SepehrMosavat/SOCRAETES/hardware/recorder/Recorder_BOM.txt

The Bill of Materials for the SOCRAETES Recorder can be found here:
https://octopart.com/bom-tool/nM2bvLOp
