SepehrMosavat/SOCRAETES/hardware/emulator/Emulator_BOM.txt

The Bill of Materials for the SOCRAETES Emulator can be found here:
https://octopart.com/bom-tool/IVWPdzGF
