SepehrMosavat/SOCRAETES/software/recorder/recording_data/measurement0.csv

20.04.2023 | 13:47:32:000 | 13:49:12:0000 | Indoor | 50 | sunny | N/A | N/A
40 | 727425 | 340
0 | 2891975 | 79
1 | 2894190 | 58
2 | 2877372 | 70
3 | 2852698 | 78
4 | 2814932 | 92
5 | 2760448 | 111
6 | 2676154 | 141
7 | 2537175 | 181
8 | 2285401 | 244
9 | 1624747 | 327
10 | 51966 | 376
11 | 25580 | 388
12 | 14703 | 395
13 | 8258 | 372
14 | 4330 | 385
15 | 2114 | 385
16 | 1007 | 401
17 | 503 | 391
18 | 503 | 386
19 | 201 | 388
20 | 201 | 391
21 | 201 | 392
22 | 302 | 381
23 | 201 | 377
24 | 302 | 392
25 | 201 | 399
26 | 201 | 364
27 | 201 | 399
28 | 201 | 392
29 | 201 | 386
30 | 201 | 402
31 | 201 | 391
32 | 201 | 390
33 | 201 | 374
34 | 302 | 378
35 | 201 | 395
36 | 302 | 392
37 | 201 | 387
38 | 201 | 407
39 | 201 | 410
0 | 2890363 | 61
1 | 2892277 | 61
2 | 2875257 | 65
3 | 2851691 | 78
4 | 2813824 | 83
5 | 2759642 | 107
6 | 2675651 | 124
7 | 2536470 | 178
8 | 2285099 | 249
9 | 1626660 | 324
10 | 51059 | 392
11 | 24270 | 398
12 | 14200 | 392
13 | 7452 | 404
14 | 4129 | 391
15 | 2215 | 386
16 | 704 | 394
17 | 503 | 401
18 | 302 | 374
19 | 201 | 375
20 | 201 | 389
21 | 302 | 394
22 | 302 | 392
23 | 302 | 379
24 | 201 | 393
25 | 201 | 379
26 | 201 | 383
27 | 201 | 380
28 | 201 | 383
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
