SepehrMosavat/SOCRAETES/software/recorder/recording_data/measurement1.csv

20.04.2023 | 13:49:14:000 | 13:50:54:0000 | Indoor | 50 | sunny | N/A | N/A
0 | 2871833 | 44
1 | 2873142 | 61
2 | 2856525 | 66
3 | 2831247 | 78
4 | 2792574 | 78
5 | 2736580 | 97
6 | 2649567 | 125
7 | 2505552 | 164
8 | 2236859 | 228
9 | 1498356 | 320
10 | 46427 | 381
11 | 22659 | 359
12 | 12387 | 374
13 | 6747 | 360
14 | 3121 | 380
15 | 1409 | 373
16 | 503 | 369
17 | 201 | 378
18 | 201 | 358
19 | 201 | 372
20 | 201 | 393
21 | 201 | 369
22 | 201 | 380
23 | 201 | 373
24 | 201 | 380
25 | 201 | 367
26 | 201 | 390
27 | 201 | 385
28 | 201 | 385
29 | 201 | 384
30 | 201 | 386
31 | 201 | 376
32 | 201 | 387
33 | 201 | 385
34 | 201 | 370
35 | 302 | 374
36 | 201 | 386
37 | 201 | 381
38 | 302 | 383
39 | 201 | 376
0 | 2871430 | 47
1 | 2873142 | 61
2 | 2857129 | 58
3 | 2831348 | 78
4 | 2791668 | 89
5 | 2736177 | 118
6 | 2649365 | 121
7 | 2504344 | 180
8 | 2236456 | 238
9 | 1496342 | 330
10 | 47534 | 375
11 | 22961 | 385
12 | 12185 | 389
13 | 6848 | 379
14 | 3121 | 381
15 | 1409 | 375
16 | 604 | 391
17 | 302 | 389
18 | 302 | 360
19 | 201 | 371
20 | 201 | 356
21 | 201 | 372
22 | 201 | 365
23 | 201 | 387
24 | 201 | 370
25 | 201 | 387
26 | 201 | 367
27 | 201 | 376
28 | 201 | 375
29 | 201 | 379
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
