SepehrMosavat/SOCRAETES/software/recorder/recording_data/measurement2.csv

20.04.2023 | 13:50:56:000 | 13:52:36:0000 | Indoor | 50 | sunny | N/A | N/A
0 | 2932561 | 41
1 | 2933870 | 63
2 | 2918260 | 71
3 | 2894996 | 73
4 | 2859043 | 91
5 | 2806271 | 98
6 | 2727113 | 142
7 | 2595788 | 171
8 | 2365969 | 250
9 | 1803305 | 341
10 | 58210 | 417
11 | 26688 | 403
12 | 15307 | 398
13 | 7754 | 405
14 | 4330 | 397
15 | 1913 | 406
16 | 906 | 407
17 | 503 | 405
18 | 503 | 407
19 | 201 | 416
20 | 302 | 418
21 | 201 | 388
22 | 201 | 381
23 | 201 | 397
24 | 201 | 396
25 | 201 | 420
26 | 201 | 412
27 | 201 | 420
28 | 201 | 418
29 | 201 | 405
30 | 302 | 404
31 | 201 | 409
32 | 201 | 417
33 | 302 | 404
34 | 302 | 400
35 | 302 | 403
36 | 201 | 394
37 | 201 | 408
38 | 302 | 411
39 | 201 | 414
0 | 2931050 | 63
1 | 2934373 | 71
2 | 2918059 | 68
3 | 2894392 | 60
4 | 2859848 | 89
5 | 2806170 | 102
6 | 2726811 | 107
7 | 2596090 | 185
8 | 2365566 | 217
9 | 1804715 | 324
10 | 58008 | 416
11 | 26083 | 394
12 | 14401 | 403
13 | 8157 | 424
14 | 4229 | 407
15 | 1510 | 401
16 | 1007 | 414
17 | 604 | 401
18 | 302 | 400
19 | 201 | 425
20 | 201 | 417
21 | 201 | 395
22 | 201 | 402
23 | 201 | 400
24 | 201 | 414
25 | 201 | 407
26 | 201 | 419
27 | 201 | 404
28 | 201 | 399
29 | 201 | 394
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
