SepehrMosavat/SOCRAETES/software/recorder/recording_data/measurement3.csv

20.04.2023 | 13:52:38:000 | 13:54:18:0000 | Indoor | 50 | sunny | N/A | N/A
0 | 2925310 | 40
1 | 2927424 | 64
2 | 2911815 | 69
3 | 2887544 | 74
4 | 2851590 | 98
5 | 2797610 | 102
6 | 2716740 | 147
7 | 2582796 | 169
8 | 2344014 | 239
9 | 1747914 | 339
10 | 55390 | 406
11 | 26083 | 416
12 | 14401 | 394
13 | 7754 | 408
14 | 3927 | 397
15 | 1913 | 394
16 | 805 | 403
17 | 402 | 412
18 | 201 | 419
19 | 402 | 410
20 | 201 | 408
21 | 201 | 384
22 | 201 | 406
23 | 201 | 407
24 | 201 | 394
25 | 201 | 411
26 | 201 | 407
27 | 201 | 423
28 | 201 | 406
29 | 201 | 408
30 | 201 | 408
31 | 302 | 401
32 | 201 | 400
33 | 201 | 415
34 | 201 | 399
35 | 302 | 394
36 | 201 | 407
37 | 201 | 405
38 | 201 | 414
39 | 201 | 415
0 | 2925310 | 67
1 | 2927727 | 61
2 | 2911613 | 58
3 | 2886134 | 76
4 | 2851590 | 83
5 | 2797106 | 128
6 | 2716539 | 126
7 | 2582091 | 174
8 | 2343813 | 244
9 | 1750432 | 322
10 | 55893 | 395
11 | 26486 | 410
12 | 13998 | 422
13 | 7855 | 392
14 | 3625 | 408
15 | 1812 | 399
16 | 1007 | 413
17 | 402 | 405
18 | 302 | 395
19 | 302 | 407
20 | 201 | 401
21 | 201 | 410
22 | 302 | 398
23 | 201 | 422
24 | 201 | 406
25 | 201 | 390
26 | 201 | 388
27 | 201 | 401
28 | 201 | 426
29 | 201 | 398
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
