SepehrMosavat/SOCRAETES/software/recorder/recording_data/measurement4.csv

20.04.2023 | 13:54:20:000 | 13:56:00:0000 | Indoor | 50 | sunny | N/A | N/A
0 | 2889256 | 42
1 | 2890968 | 61
2 | 2873948 | 75
3 | 2848468 | 63
4 | 2809997 | 90
5 | 2753701 | 123
6 | 2665983 | 122
7 | 2520054 | 187
8 | 2251160 | 247
9 | 1512959 | 333
10 | 47434 | 390
11 | 23364 | 384
12 | 13293 | 403
13 | 7553 | 396
14 | 3121 | 398
15 | 1409 | 400
16 | 604 | 390
17 | 503 | 387
18 | 302 | 379
19 | 201 | 402
20 | 201 | 392
21 | 201 | 384
22 | 201 | 398
23 | 201 | 383
24 | 201 | 387
25 | 201 | 413
26 | 201 | 390
27 | 201 | 387
28 | 302 | 377
29 | 201 | 383
30 | 302 | 399
31 | 201 | 398
32 | 201 | 390
33 | 201 | 407
34 | 201 | 409
35 | 302 | 387
36 | 201 | 409
37 | 302 | 392
38 | 201 | 392
39 | 201 | 384
0 | 2888651 | 60
1 | 2890363 | 62
2 | 2872941 | 85
3 | 2848871 | 74
4 | 2809292 | 114
5 | 2752693 | 114
6 | 2665580 | 129
7 | 2520357 | 180
8 | 2250757 | 248
9 | 1507219 | 327
10 | 47736 | 393
11 | 23465 | 386
12 | 12991 | 375
13 | 7049 | 412
14 | 3222 | 382
15 | 1611 | 382
16 | 604 | 389
17 | 503 | 400
18 | 302 | 395
19 | 201 | 391
20 | 201 | 382
21 | 201 | 378
22 | 201 | 385
23 | 201 | 368
24 | 201 | 398
25 | 201 | 382
26 | 201 | 397
27 | 201 | 420
28 | 201 | 390
29 | 201 | 387
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
