SepehrMosavat/SOCRAETES/software/recorder/recording_data/measurement5.csv

20.04.2023 | 13:56:02:000 | 13:57:42:0000 | Indoor | 50 | sunny | N/A | N/A
0 | 2868006 | 53
1 | 2870121 | 65
2 | 2852497 | 90
3 | 2825204 | 87
4 | 2784518 | 89
5 | 2725502 | 111
6 | 2632547 | 149
7 | 2476749 | 157
8 | 2178750 | 240
9 | 1296433 | 345
10 | 42398 | 378
11 | 20947 | 404
12 | 11984 | 393
13 | 6546 | 380
14 | 3323 | 384
15 | 1510 | 376
16 | 604 | 383
17 | 201 | 391
18 | 302 | 395
19 | 201 | 393
20 | 201 | 393
21 | 201 | 379
22 | 201 | 372
23 | 201 | 390
24 | 201 | 388
25 | 201 | 395
26 | 201 | 378
27 | 201 | 390
28 | 201 | 387
29 | 201 | 402
30 | 201 | 381
31 | 201 | 386
32 | 201 | 397
33 | 302 | 388
34 | 201 | 381
35 | 201 | 398
36 | 201 | 385
37 | 201 | 386
38 | 201 | 407
39 | 201 | 387
0 | 2867502 | 65
1 | 2869919 | 62
2 | 2852295 | 74
3 | 2824298 | 71
4 | 2784014 | 102
5 | 2724898 | 112
6 | 2633252 | 132
7 | 2475742 | 203
8 | 2178548 | 238
9 | 1297843 | 365
10 | 42398 | 374
11 | 21249 | 390
12 | 11984 | 399
13 | 6143 | 406
14 | 2920 | 383
15 | 1812 | 385
16 | 805 | 390
17 | 302 | 381
18 | 302 | 377
19 | 201 | 406
20 | 201 | 369
21 | 201 | 388
22 | 201 | 396
23 | 201 | 393
24 | 201 | 379
25 | 201 | 394
26 | 201 | 391
27 | 201 | 388
28 | 201 | 396
29 | 302 | 404
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
