SepehrMosavat/SOCRAETES/hardware/emulator/Emulator.brd

## EAGLE design hardware/emulator/Emulator.brd (2023-07-11)

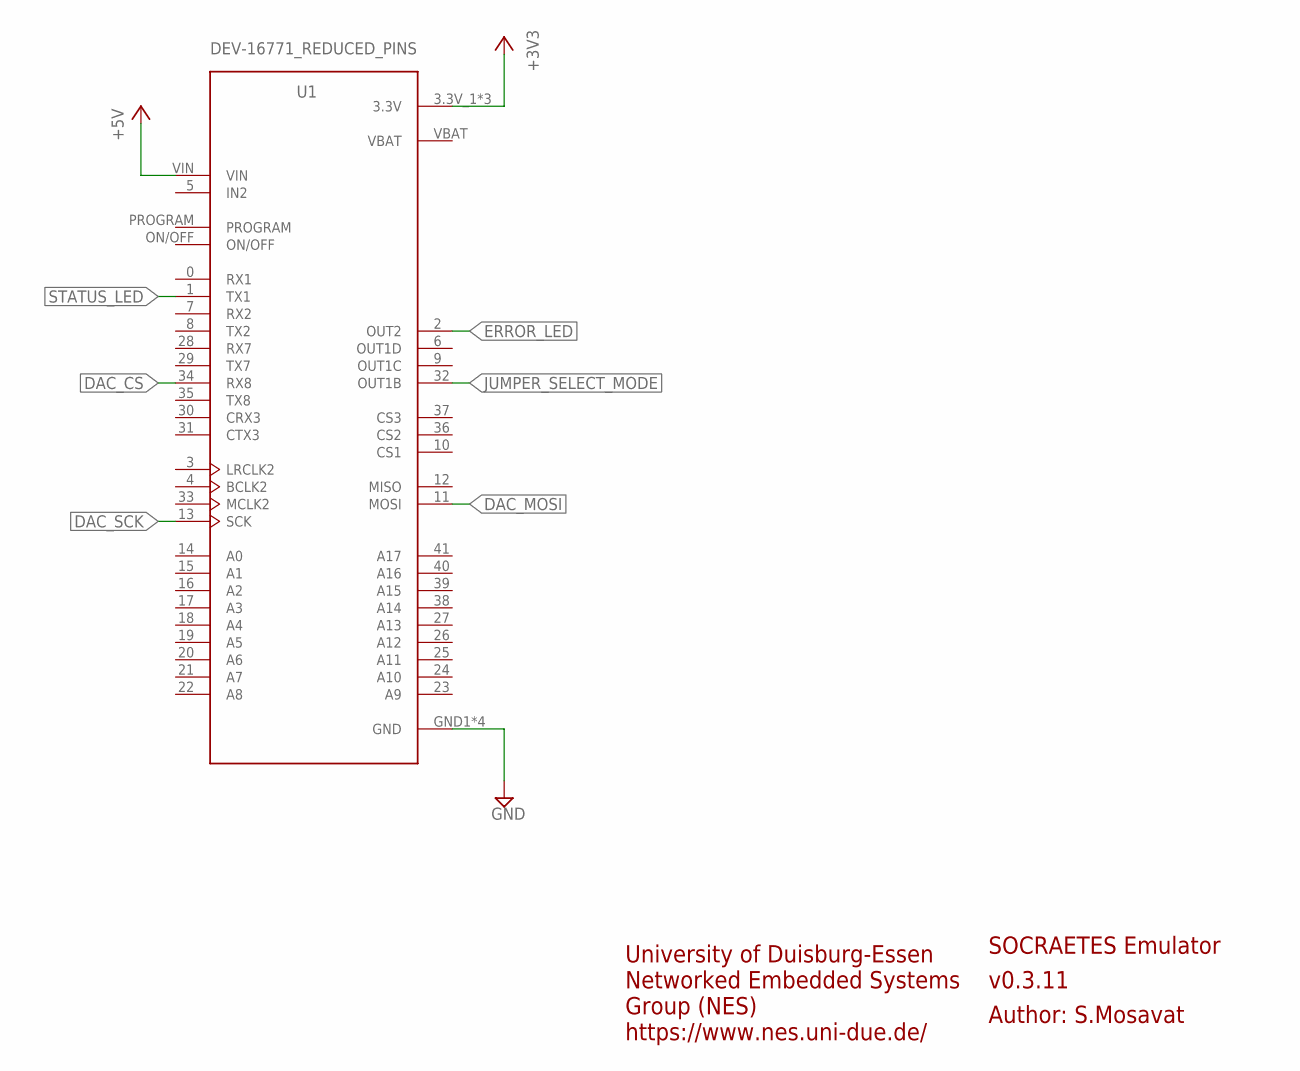
[picture p1: schematic Emulator.sch, sheet 1, MCU]

Parts:
U1: DEV-16771_REDUCED_PINS; MODULE_DEV-16771_REDUCED_PINS

Connections:
+3V3: U1.3.3V_1 (3.3V), U1.3.3V_2 (3.3V), U1.3.3V_3 (3.3V); also elsewhere on the board
+5V: U1.VIN; also elsewhere on the board
DAC_CS: U1.34 (RX8); also elsewhere on the board
DAC_MOSI: U1.11 (MOSI); also elsewhere on the board
DAC_SCK: U1.13 (SCK); also elsewhere on the board
ERROR_LED: U1.2 (OUT2); also elsewhere on the board
GND: U1.GND1 (GND), U1.GND2 (GND), U1.GND3 (GND), U1.GND4 (GND); also elsewhere on the board
JUMPER_SELECT_MODE: U1.32 (OUT1B); also elsewhere on the board
STATUS_LED: U1.1 (TX1); also elsewhere on the board

Notes on the sheet:
SOCRAETES Emulator
v0.3.11
Author: S.Mosavat
University of Duisburg-Essen Networked Embedded Systems Group (NES) https://www.nes.uni-due.de/

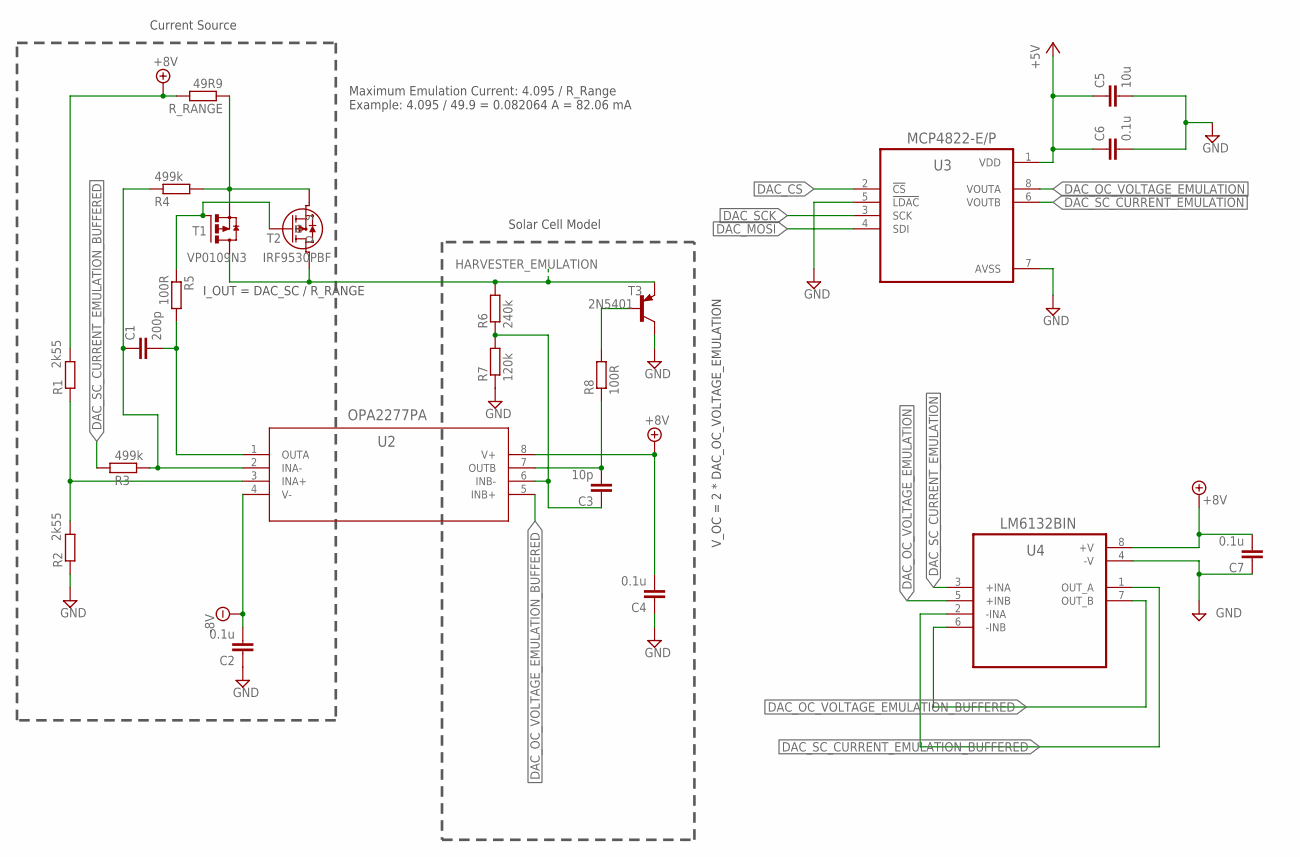
[picture p2: schematic Emulator.sch, sheet 2, Analog front-end]

Parts:
C1: 200p; C025-024X044
C2, C4, C6, C7: 0.1u; C025-024X044
C3: 10p; C025-024X044
C5: 10u; C025-024X044
R1, R2: 2k55; 0207/10
R3, R4: 499k; 0207/10
R5, R8: 100R; 0207/10
R6: 240k; 0207/10
R7: 120k; 0207/10
R_RANGE: 49R9; 0207/10
T1: VP0109N3; TO92-SGD
T2: IRF9530PBF; TO220AB_VIS
T3: 2N5401; TO92-EBC
U2: OPA2277PA; P8
U3: MCP4822-E/P; DIP787W46P254L927H533Q8
U4: LM6132BIN; DIP794W45P254L959H508Q8

Connections:
+5V: C5.1, C6.1, U3.1 (VDD); also elsewhere on the board
+8V: C4.2, C7.2, R1.2, R_RANGE.2, U2.8 (V+), U4.8 (+V); also elsewhere on the board
-8V: C2.2, U2.4 (V-); also elsewhere on the board
DAC_CS: U3.2 (!CS); also elsewhere on the board
DAC_MOSI: U3.4 (SDI); also elsewhere on the board
DAC_OC_VOLTAGE_EMULATION: U3.8 (VOUTA), U4.5 (+INB)
DAC_OC_VOLTAGE_EMULATION_BUFFERED: U2.5 (INB+), U4.6 (-INB), U4.7 (OUT_B)
DAC_SCK: U3.3 (SCK); also elsewhere on the board
DAC_SC_CURRENT_EMULATION: U3.6 (VOUTB), U4.3 (+INA)
DAC_SC_CURRENT_EMULATION_BUFFERED: R3.2, U4.1 (OUT_A), U4.2 (-INA)
GND: C2.1, C4.1, C5.2, C6.2, C7.1, R2.1, R7.1, T3.C, U3.5 (!LDAC), U3.7 (AVSS), U4.4 (-V); also elsewhere on the board
HARVESTER_EMULATION: R6.2, T1.DRAIN (D), T2.D, T3.E; also elsewhere on the board
unnamed: R1.1, R2.2, U2.3 (INA+)
unnamed: C1.1, R3.1, R4.2, U2.2 (INA-)
unnamed: R5.1, T1.GATE (G), T2.G
unnamed: C1.2, R5.2, U2.1 (OUTA)
unnamed: R4.1, R_RANGE.1, T1.SOURCE (S), T2.S
unnamed: C3.1, R6.1, R7.2, U2.6 (INB-)
unnamed: R8.2, T3.B
unnamed: C3.2, R8.1, U2.7 (OUTB)

Notes on the sheet:
Current Source
Solar Cell Model
Maximum Emulation Current: 4.095 / R_Range Example: 4.095 / 49.9 = 0.082064 A = 82.06 mA
I_OUT = DAC_SC / R_RANGE
V_OC = 2 * DAC_OC_VOLTAGE_EMULATION

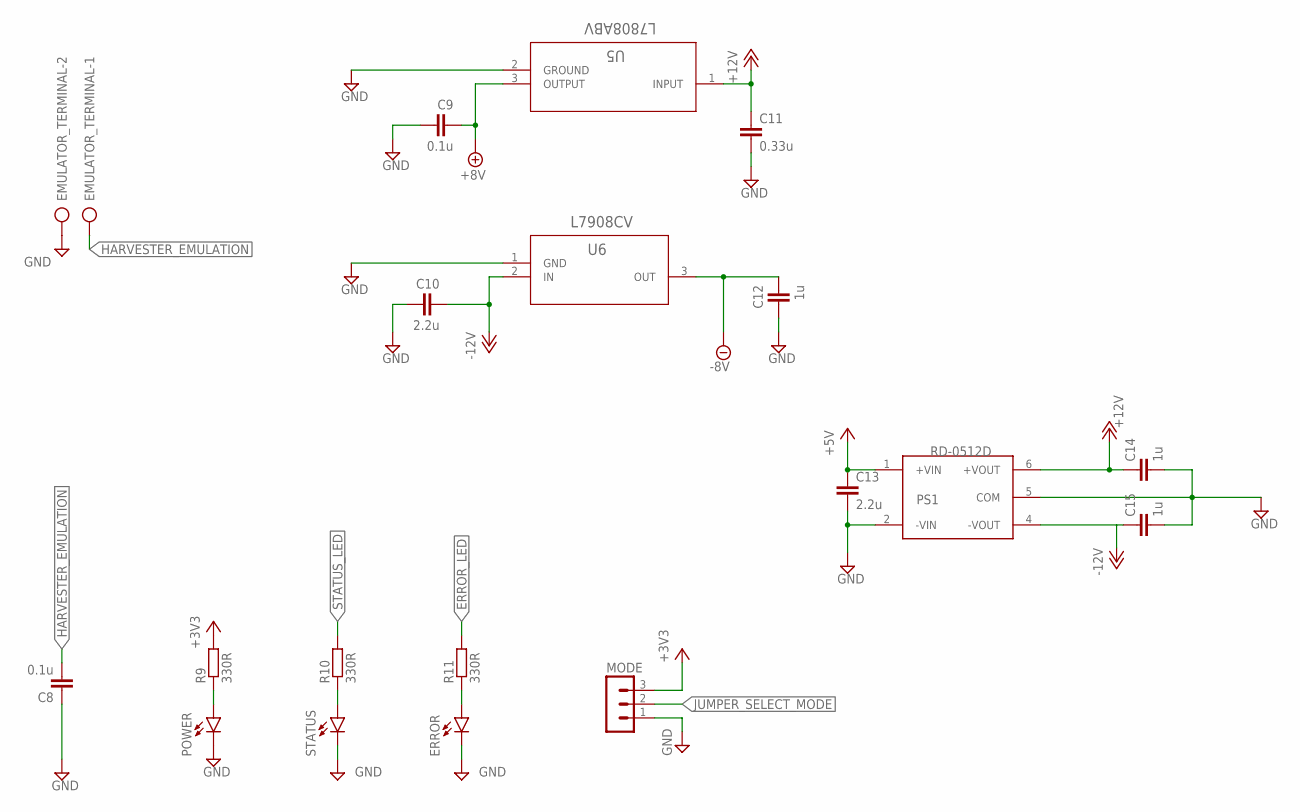
[picture p3: schematic Emulator.sch, sheet 3, Power]

Parts:
C8, C9: 0.1u; C025-024X044
C10, C13: 2.2u; C025-024X044
C11: 0.33u; C025-024X044
C12, C14, C15: 1u; C025-024X044
EMULATOR_TERMINAL: AK300/2
ERROR: LED5MM
MODE: MA03-1
POWER: LED5MM
PS1: RD-0512D; CONV_RD-0512D
R9, R10, R11: 330R; 0207/10
STATUS: LED5MM
U5: L7808ABV; TO-220_STM
U6: L7908CV; TO-220_STM

Connections:
+3V3: MODE.3, R9.2; also elsewhere on the board
+5V: C13.1, PS1.1 (+VIN); also elsewhere on the board
+8V: C9.2, U5.3 (OUTPUT); also elsewhere on the board
+12V: C11.1, C14.1, PS1.6 (+VOUT), U5.1 (INPUT)
-8V: C12.2, U6.3 (OUT); also elsewhere on the board
-12V: C10.2, C15.1, PS1.4 (-VOUT), U6.2 (IN)
ERROR_LED: R11.2; also elsewhere on the board
GND: C8.1, C9.1, C10.1, C11.2, C12.1, C13.2, C14.2, C15.2, EMULATOR_TERMINAL.2, ERROR.K (C), MODE.1, POWER.K (C), PS1.2 (-VIN), PS1.5 (COM), STATUS.K (C), U5.2 (GROUND), U6.1 (GND); also elsewhere on the board
HARVESTER_EMULATION: C8.2, EMULATOR_TERMINAL.1; also elsewhere on the board
JUMPER_SELECT_MODE: MODE.2; also elsewhere on the board
unnamed: R10.1, STATUS.A
unnamed: ERROR.A, R11.1
unnamed: POWER.A, R9.1
STATUS_LED: R10.2; also elsewhere on the board

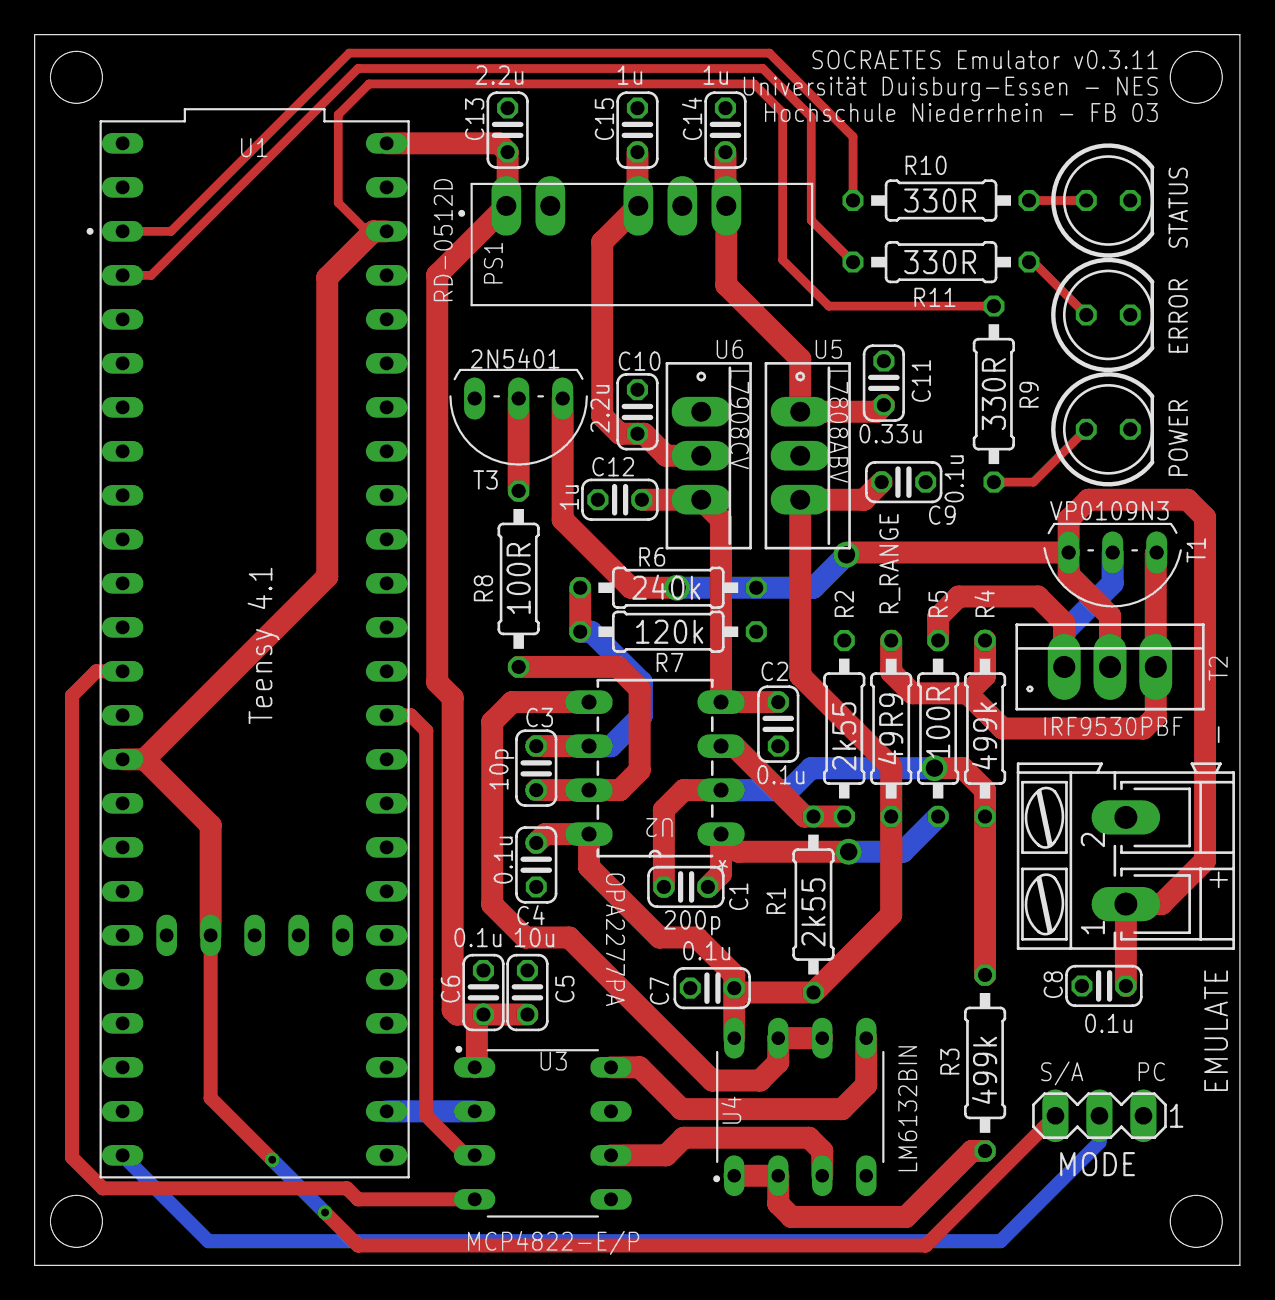
[picture p4: board Emulator.brd from above]

Board: 2 copper layers, 69.6 x 71.0 mm, 42 parts (0 on the bottom side), 29 nets.
