SepehrMosavat/SOCRAETES/hardware/recorder/Recorder.brd

## EAGLE design hardware/recorder/Recorder.brd (2023-05-26)

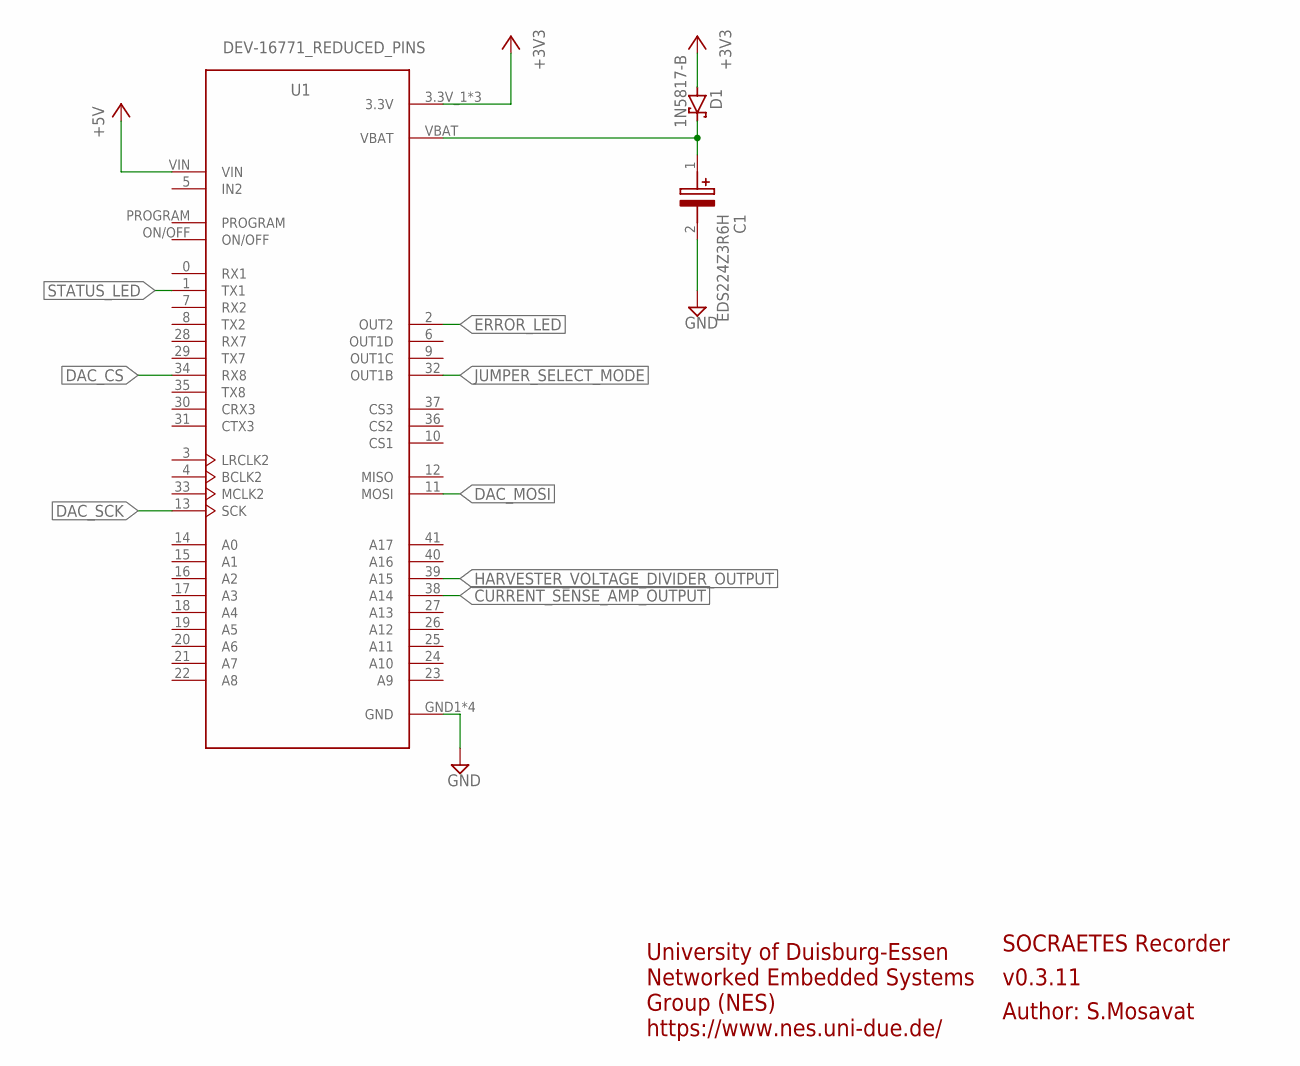
[picture p5: schematic Recorder.sch, sheet 1, MCU]

Parts:
C1: EDS224Z3R6H
D1: 1N5817-B; DO41-7.6
U1: DEV-16771_REDUCED_PINS; MODULE_DEV-16771_REDUCED_PINS

Connections:
+3V3: D1.A, U1.3.3V_1 (3.3V), U1.3.3V_2 (3.3V), U1.3.3V_3 (3.3V); also elsewhere on the board
+5V: U1.VIN; also elsewhere on the board
CURRENT_SENSE_AMP_OUTPUT: U1.38 (A14); also elsewhere on the board
DAC_CS: U1.34 (RX8); also elsewhere on the board
DAC_MOSI: U1.11 (MOSI); also elsewhere on the board
DAC_SCK: U1.13 (SCK); also elsewhere on the board
ERROR_LED: U1.2 (OUT2); also elsewhere on the board
GND: C1.2 (-), U1.GND1 (GND), U1.GND2 (GND), U1.GND3 (GND), U1.GND4 (GND); also elsewhere on the board
HARVESTER_VOLTAGE_DIVIDER_OUTPUT: U1.39 (A15); also elsewhere on the board
JUMPER_SELECT_MODE: U1.32 (OUT1B); also elsewhere on the board
unnamed: C1.1 (+), D1.C, U1.VBAT
STATUS_LED: U1.1 (TX1); also elsewhere on the board

Notes on the sheet:
SOCRAETES Recorder
v0.3.11
Author: S.Mosavat
University of Duisburg-Essen Networked Embedded Systems Group (NES) https://www.nes.uni-due.de/

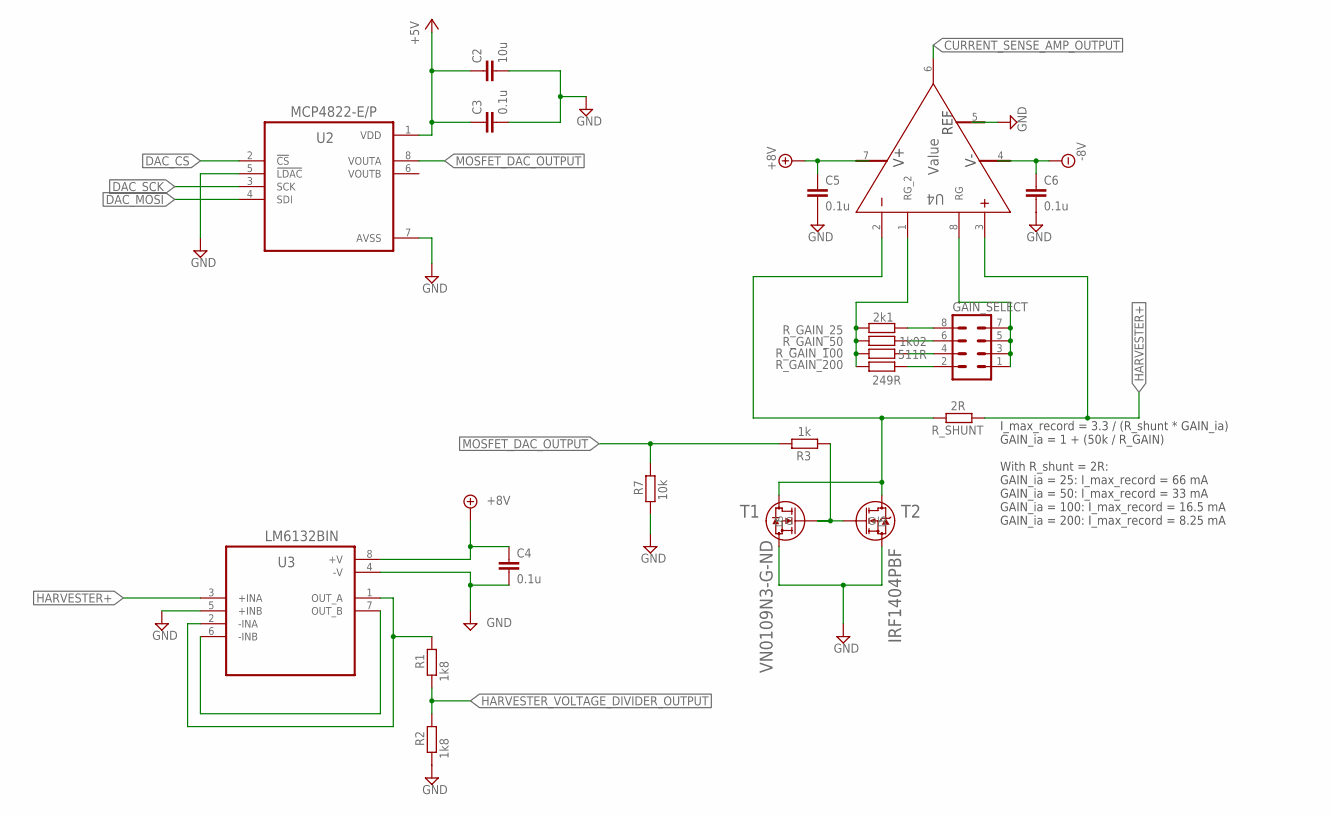
[picture p6: schematic Recorder.sch, sheet 2, Analog front-end]

Parts:
C2: 10u; C025-024X044
C3, C4, C5, C6: 0.1u; C025-024X044
GAIN_SELECT: MA04-2
R1, R2: 1k8; 0207/10
R3: 1k; 0207/10
R7: 10k; 0207/10
R_GAIN_25: 2k1; 0207/10
R_GAIN_50: 1k02; 0207/10
R_GAIN_100: 511R; 0207/10
R_GAIN_200: 249R; 0207/10
R_SHUNT: 2R; 0207/10
T1: VN0109N3-G-ND; TO92-CBE
T2: IRF1404PBF; PG-TO220-3-904_INF
U2: MCP4822-E/P; DIP787W46P254L927H533Q8
U3: LM6132BIN; DIP794W45P254L959H508Q8
U4: Value; P0008A

Connections:
+5V: C2.1, C3.1, U2.1 (VDD); also elsewhere on the board
+8V: C4.1, C5.1, U3.8 (+V), U4.7 (V+); also elsewhere on the board
-8V: C6.1, U4.4 (V-); also elsewhere on the board
CURRENT_SENSE_AMP_OUTPUT: U4.6 (OUT); also elsewhere on the board
DAC_CS: U2.2 (!CS); also elsewhere on the board
DAC_MOSI: U2.4 (SDI); also elsewhere on the board
DAC_SCK: U2.3 (SCK); also elsewhere on the board
GND: C2.2, C3.2, C4.2, C5.2, C6.2, R2.1, R7.1, T1.SOURCE (S), T2.S, U2.5 (!LDAC), U2.7 (AVSS), U3.4 (-V), U3.5 (+INB), U4.5 (REF); also elsewhere on the board
HARVESTER+: R_SHUNT.1, U3.3 (+INA), U4.3 (IN+); also elsewhere on the board
HARVESTER_VOLTAGE_DIVIDER_OUTPUT: R1.1, R2.2; also elsewhere on the board
MOSFET_DAC_OUTPUT: R3.2, R7.2, U2.8 (VOUTA)
unnamed: GAIN_SELECT.8, R_GAIN_25.1
unnamed: GAIN_SELECT.6, R_GAIN_50.1
unnamed: U3.6 (-INB), U3.7 (OUT_B)
unnamed: R_SHUNT.2, T1.DRAIN (D), T2.D, U4.2 (IN-)
unnamed: R1.2, U3.1 (OUT_A), U3.2 (-INA)
unnamed: GAIN_SELECT.4, R_GAIN_100.1
unnamed: R3.1, T1.GATE (G), T2.G
unnamed: R_GAIN_25.2, R_GAIN_50.2, R_GAIN_100.2, R_GAIN_200.2, U4.1 (RG_2)
unnamed: GAIN_SELECT.1, GAIN_SELECT.3, GAIN_SELECT.5, GAIN_SELECT.7, U4.8 (RG)
unnamed: GAIN_SELECT.2, R_GAIN_200.1

Notes on the sheet:
I_max_record = 3.3 / (R_shunt * GAIN_ia) GAIN_ia = 1 + (50k / R_GAIN) With R_shunt = 2R: GAIN_ia = 25: I_max_record = 66 mA GAIN_ia = 50: I_max_record = 33 mA GAIN_ia = 100: I_max_record = 16.5 mA GAIN_ia = 200: I_max_record = 8.25 mA

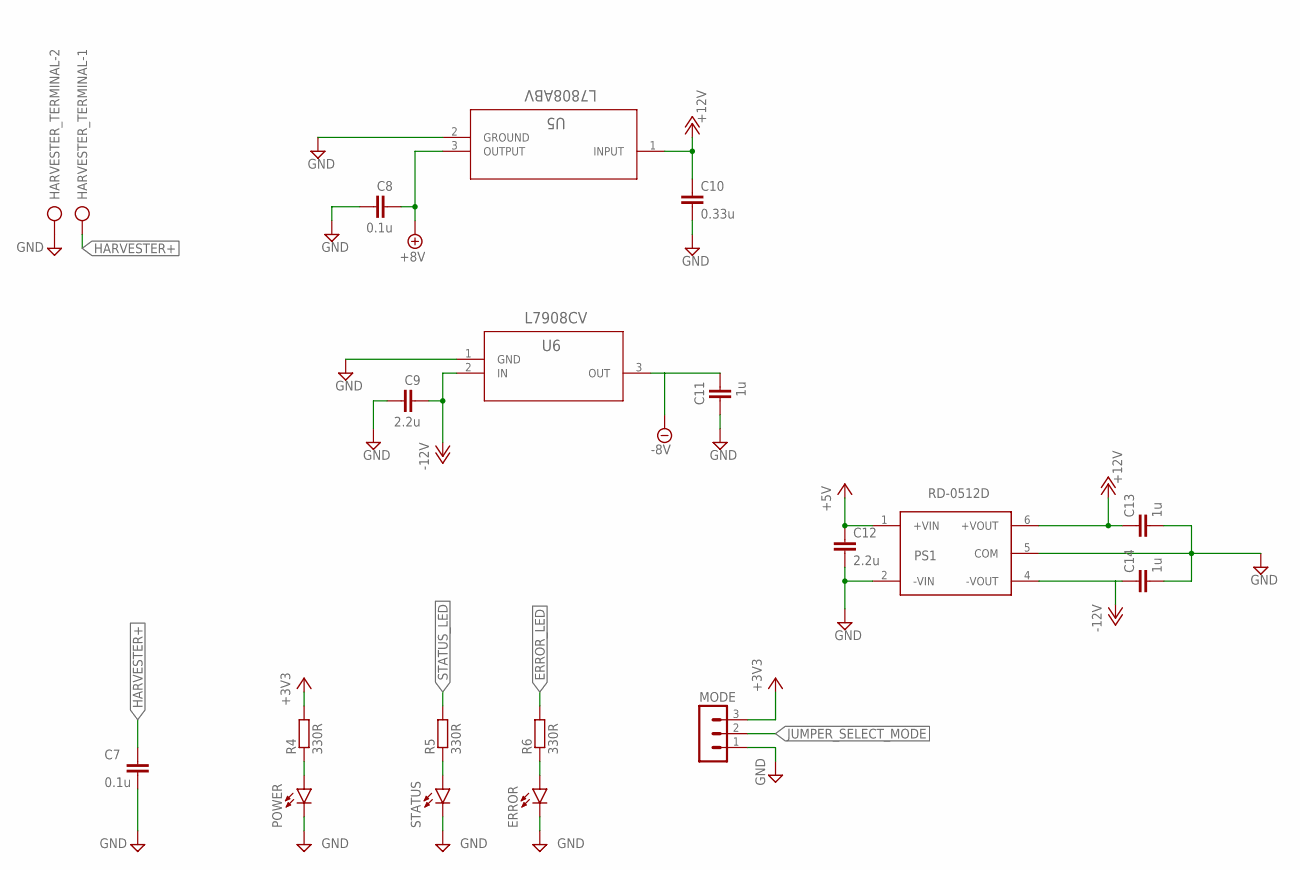
[picture p7: schematic Recorder.sch, sheet 3, Power]

Parts:
C7, C8: 0.1u; C025-024X044
C9, C12: 2.2u; C025-024X044
C10: 0.33u; C025-024X044
C11, C13, C14: 1u; C025-024X044
ERROR: LED5MM
HARVESTER_TERMINAL: AK300/2
MODE: MA03-1
POWER: LED5MM
PS1: RD-0512D; CONV_RD-0512D
R4, R5, R6: 330R; 0207/10
STATUS: LED5MM
U5: L7808ABV; TO-220_STM
U6: L7908CV; TO-220_STM

Connections:
+3V3: MODE.3, R4.2; also elsewhere on the board
+5V: C12.1, PS1.1 (+VIN); also elsewhere on the board
+8V: C8.2, U5.3 (OUTPUT); also elsewhere on the board
+12V: C10.1, C13.1, PS1.6 (+VOUT), U5.1 (INPUT)
-8V: C11.2, U6.3 (OUT); also elsewhere on the board
-12V: C9.2, C14.1, PS1.4 (-VOUT), U6.2 (IN)
ERROR_LED: R6.2; also elsewhere on the board
GND: C7.2, C8.1, C9.1, C10.2, C11.1, C12.2, C13.2, C14.2, ERROR.K (C), HARVESTER_TERMINAL.2, MODE.1, POWER.K (C), PS1.2 (-VIN), PS1.5 (COM), STATUS.K (C), U5.2 (GROUND), U6.1 (GND); also elsewhere on the board
HARVESTER+: C7.1, HARVESTER_TERMINAL.1; also elsewhere on the board
JUMPER_SELECT_MODE: MODE.2; also elsewhere on the board
unnamed: ERROR.A, R6.1
unnamed: R5.1, STATUS.A
unnamed: POWER.A, R4.1
STATUS_LED: R5.2; also elsewhere on the board

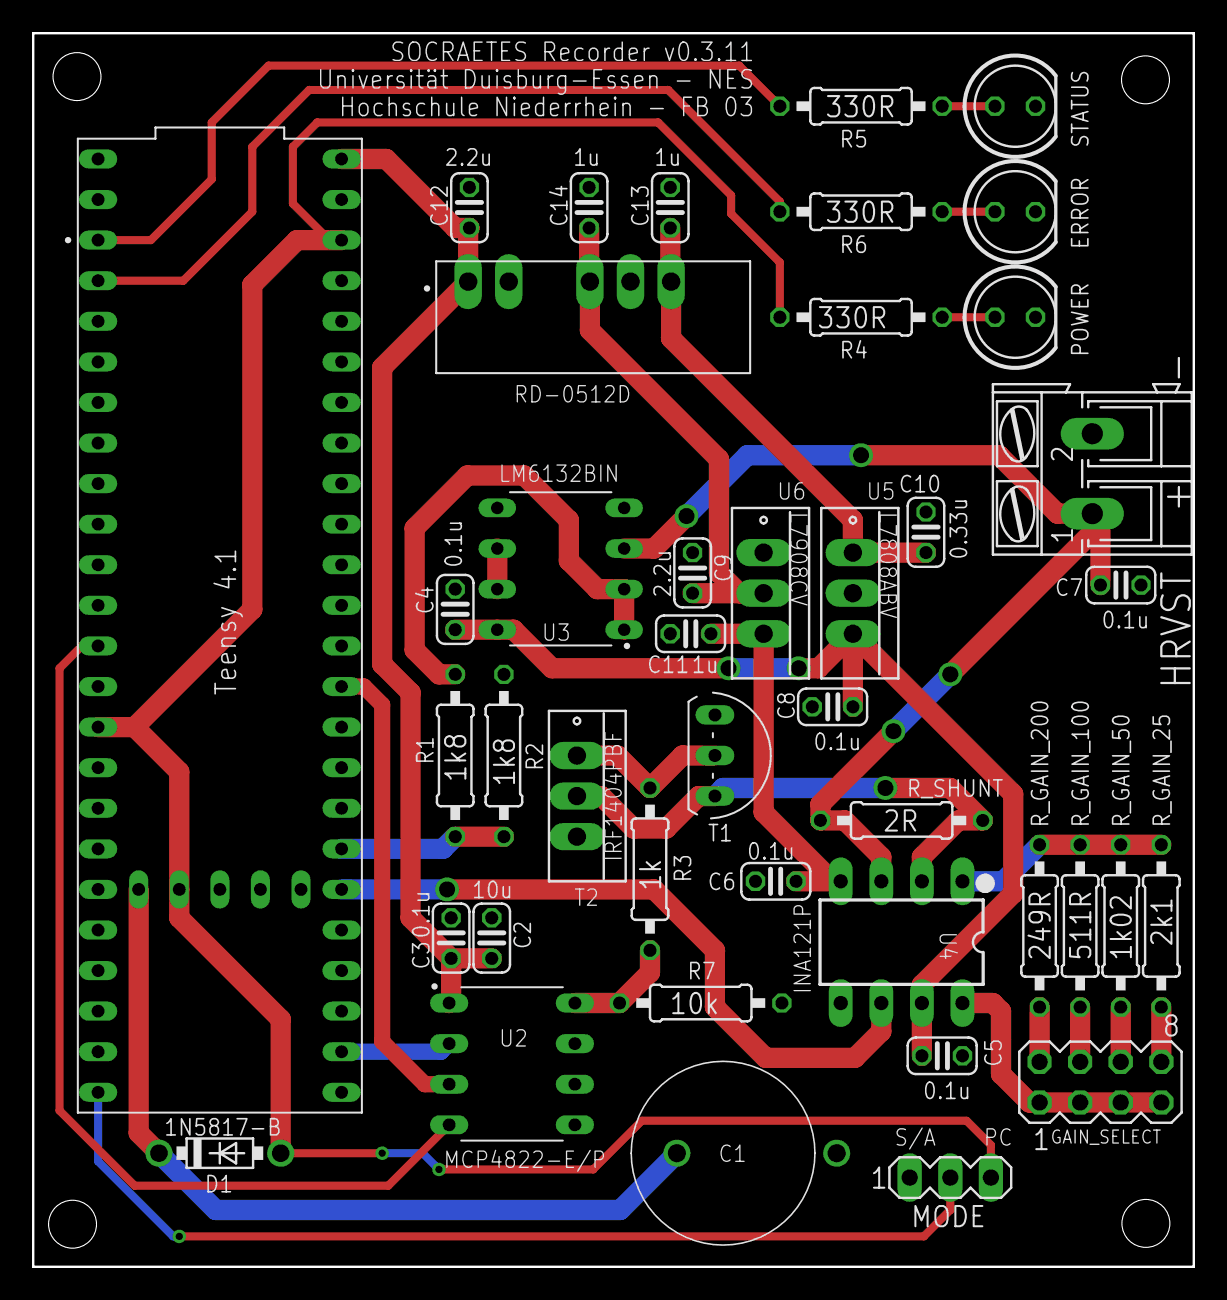
[picture p8: board Recorder.brd from above]

Board: 2 copper layers, 72.6 x 77.2 mm, 42 parts (0 on the bottom side), 31 nets.
