SepehrMosavat/SOCRAETES/firmware/recorder/configuration_file.txt

duration=100
Indoor/Oudoor=Indoor
Lux=50
weather=sunny
Country=N/A
City=N/A
Harvesting Source=solar cell
