SepehrMosavat/SOCRAETES/recorder/firmware/HelperFunctions.h

/*
 * HelperFunctions.h
 *
 *  Created on: 02.09.2020
 *      Author: Sayedsepehr Mosavat
 *      University of Duisburg-Essen
 *      Networked Embedded Systems (NES)
 */

#ifndef HELPERFUNCTIONS_H_
#define HELPERFUNCTIONS_H_


#include "Definitions.h"
#include <Arduino.h>

float shortToVoltage(short);

int getVoltageFromAdcValue(int, int);

int getCurrentFromAdcValue(int);

void convertIntValuesToByteArrays(unsigned short, int, int, byte*);

void initializeADC();

void updateHarvesterLoad();


#endif /* HELPERFUNCTIONS_H_ */
