SepehrMosavat/SOCRAETES/software/recorder/iv_curves_definitions.py

class IvCurve:
    number_of_points_in_curve = 40

    def __init__(self, _curve_number):
        self.curve_number = _curve_number
        self.curve_points_list = []

    def add_point_to_curve(self, _curve_point):
        self.curve_points_list.append(_curve_point)

    def print(self):
        for i in self.curve_points_list:
            print("V: " + str(i.x) + ", I: " + str(i.y))


class CurvePoint:
    def __init__(self, _sequence_number, _x, _y):
        self.sequence_number = _sequence_number
        self.x = _x
        self.y = _y


class HarvestingCondition:
    def __init__(self, _indoor_or_outdoor: str, _light_intensity: str, _weather_condition: str, _country: str,
                 _city: str, _source: str):
        self.indoor_or_outdoor = _indoor_or_outdoor
        self.light_intensity = _light_intensity
        self.weather_condition = _weather_condition
        self.country = _country
        self.city = _city
        self.source = _source
