SepehrMosavat/SOCRAETES/(commit log)

2020-09-17 Fix eclipse integration issues
    [SolarCellRecorderAndEmulator.ino]
2020-09-17 Update ADC reference voltage definition
2020-09-17 Increase PGA's gain used for current measurement
2020-09-17 Decrease PGA's gain used for current measurement to avoid saturation issues at high currents
    [Definitions.h]
2020-09-17 Use a look up table instead of continuously counting up for the value of digital potentiometer
    This helps with lower noise and a smoother captured curve
    [Definitions.h, SolarCellRecorderAndEmulator.ino]
2020-09-17 Change the path of recorded traces to a separate directory
2020-09-17 Specify data type in the HDF5 file containing the captured traces
2020-09-18 Add error checking for empty folder
    [disk_io_functions.py]
2020-09-25 Add check for negative ADC readings for current and voltage calculations
2020-10-15 Remove DAC and rotary encoder from the current project
2020-10-15 Replace digital potentiometer as system load with a MOSFET controlled by the DAC
    [Definitions.h, HelperFunctions.cpp, HelperFunctions.h, SolarCellRecorderAndEmulator.ino]
2020-10-15 Add function for updating the MOSFET load on each main loop iteration
2020-10-15 Change the value of the resistors in the voltage divider used for measuring the harvester voltage
2020-10-15 Reduce ADC resolution
2020-10-15 Modify ADC settings for improving the quality of current/voltage measurements
2020-10-15 Add a delay at the end of main loop for better current/voltage measurements
2020-10-15 Use single-ended ADC input instead of differential inputs for harvester current measurements
2020-10-15 Remove "capture status" pins since this functionality is no longer needed
    [SolarCellRecorderAndEmulator.ino]
2020-10-15 Use 16-bit ADC resolution for current measurements
2020-10-15 Modify shunt resistor and current sense amplifier gain to achieve better accuracy over a wider measurement range
2020-10-16 Implement calibration mode for easy calibration of the current/voltage measurements
2020-10-16 Add another shunt resistor for measuring smaller, low-current output harvesters
2020-10-22 Add new look-up table for the load MOSFET
    The higher DAC voltage results in a lower drain-source ON-state resistance
2021-01-13 Add 15 seconds of delay at the startup
    This delay serves as a solution for the serial communication
    issues on Linux systems. The delay will be signaled to the user
    by utilizing the on-board LED.
    [Functions.cpp, Functions.h, SOCRAETES_recorder.ino]
2021-01-19 Add event for thread synchronization
    The event will notify the thread to stop at the end of program execution.
2021-01-19 Implement timer thread for measuring the data capture duration
2021-01-19 Start threads in the main function after getting the CLI parameters from the user
2021-01-19 Move matplotlib threads to the main execution thread to prevent threading issues
2021-02-02 Add hardware CAD files
    [Emulator.brd, Emulator.sch, Recorder.brd, Recorder.sch]
2021-02-16 Update emulator hardware
    [Emulator.brd, Emulator.sch]
2021-02-16 Add emulator BOM
2021-02-16 Update recorder hardware
    [Recorder.brd, Recorder.sch]
2021-02-16 Add recorder BOM
2021-02-16 Add definition for the emulator range resistor
2021-02-16 Update pins for compatibility with Teensy 3.6
2021-02-16 Update values of the voltage resistor
2021-02-16 Update current sense shunt resistor value
2021-02-17 Correct board version on the silkscreen
    [Emulator.brd, Recorder.brd]
2021-03-08 Add vias, fix ground pour on the top layer
    [Recorder.brd]
2021-03-08 Fix ADC pins for the PCB
    [Definitions.h]
2021-03-08 Increase ADC resolution
2021-03-08 Use maximum ADC sampling and conversion speed
2021-03-08 Increase number of ADC samples used for averaging
2021-04-26 Fix DAC pin numbers
    [Definitions.h]
2021-04-26 Add offset for calibration of the DAC output for short-circuit current emulation
    [Definitions.h, Functions.cpp]
2021-04-26 Toggle the LED on each emulated curve to provide the user a visual cue
2021-04-26 Change the gain of the IA to 99 for the current board
2021-04-26 Use a new LUT for capturing the IV curves.
    The new LUT exhibits a better performance over the entire range of current measurement.
2021-04-26 Add calibration offsets and check the return value to make sure it is not negative
2021-04-26 Add a capacitor to the solar cell model op amp for stability of the op amp's output
    [Emulator.brd, Emulator.sch]
2021-04-26 Improve the format and readability of the information printed during emulation
2021-04-26 Add PCB v0.1.2 images
2021-05-26 Fix maximum sequence number of the points in each curve
    [Functions.cpp]
2021-05-26 Flush serial input buffer to fix the issue of starting the curve capturing
    [solar_cell_recorder_functions.py]
2021-05-26 Fix the issue with the inconsistent number of points in each curve
    [solar_cell_recorder_functions.py]
2021-05-26 Add a feature for emulating an intermittent power source with adjustable power on/off cycles
    This is an experimental feature and is not meant for normal use.
2023-04-06 Add minor changes to the schematics
    [Emulator.sch, Recorder.sch]
2023-04-06 Fix timing issue with disk commits
    [disk_io_functions.py]
2023-04-06 Fix bug in curve point sequence numbers
    [solar_cell_recorder_functions.py]
2023-04-20 first working state
    [configuration_file.txt, measurement0.csv, measurement1.csv, measurement2.csv, measurement3.csv, measurement4.csv, measurement5.csv, measurement6.csv]
2023-04-21 add bug fix if captured_traces directory doesn't exists
    [disk_io_functions.py]
2023-04-21 Change calculation of CURRENT_SENSE_AMPLIFIER_GAIN to floating point
2023-04-21 Make path for captured traces os independent
2023-04-25 Fix typo, change cycle time, ivCurveSequenceNumber handling,
    [Definitions.h, Functions.cpp, SOCRAETES_recorder.ino]
2023-04-25 Change uartByteArray from extern to static
2023-04-26 fixed configuration file read in
    [configuration_file.txt]
2023-04-27 Migrate emulator board to Teensy 4.1
    [Emulator.brd, Emulator.sch]
2023-04-27 Migrate recorder board to Teensy 4.1
    [Recorder.brd, Recorder.sch]
2023-04-27 Update pin mappings
2023-04-27 Update reference voltages
2023-04-27 Update ADC settings for Teensy 4.1
2023-04-27 Decrease ADC resolution to 12 bits for Teensy 4.1
2023-04-27 Use the status LED instead of the built-in one
2023-04-27 Update current and voltage readings with the ADC
2023-04-27 Add debug information for the calibration mode
2023-04-27 Update the LUT for load MOSFET gate voltages during load sweep with MCP4822
2023-04-27 added harvesting source in harvesting conditions
    [configuration_file.txt]
2023-04-27 Add resistor for gain=200
2023-04-27 Increase shunt resistor to 2R
2023-04-27 Fix amplifier gain calculation
    [Definitions.h]
2023-04-27 Add error LED to the board
    [Emulator.brd, Emulator.sch, Recorder.brd, Recorder.sch]
2023-04-27 Update gain resistor
2023-04-27 Move supercapacitor
    [Recorder.brd]
2023-04-28 Mask unused variables, functions to avoid compiler warnings
    [Functions.cpp]
2023-04-28 Do not activate CALIBRATION_MODE automatically when DEBUG_MODE is active
2023-04-28 Make ADC a local variable, change timing in DEBUG_MODE
2023-05-03 Switch timing to elapsedMillis to handle roll over
2023-05-03 Correct format specifier for unsigned long
    [SOCRAETES_recorder.ino]
2023-05-16 Migrate emulator firmware to Teensy 4.1
2023-05-16 Update (unused) UART baud rate
2023-05-16 Update emulator current range resistor
2023-05-16 Reduce ADC resolution to 10 bits
2023-05-16 Add error LED
2023-05-16 Add minor changes to the hardware
    [Emulator.brd, Emulator.sch, Recorder.brd, Recorder.sch]
2023-05-17 Update part designators
    [Emulator.brd, Emulator.sch, Recorder.brd, Recorder.sch]
2023-05-17 restored status led functionality
2023-05-22 Update resistor values
    [Emulator.brd, Emulator.sch]
2023-05-22 Update info text
    [Emulator.sch]
2023-05-24 Update the emulation MOSFET device
    [Emulator.brd, Emulator.sch]
2023-05-24 Update board version
    [Emulator.brd, Emulator.sch]
2023-05-24 Add new recorder MOSFET and update the existing one
    [Recorder.brd, Recorder.sch]
2023-05-25 add error led functionality
    [SOCRAETES_emulator.ino]
2023-05-26 fix function declaration bug
    [Functions.h]
2023-07-11 Update resistor value
    [Emulator.brd, Emulator.sch]
2023-07-12 Readd MCP48xx library because of SPI bug
2023-07-12 Add LUT for the IRF1404 MOSFET
2023-08-01 Replace dynamic memory allocation by reading file line by line
    [Functions.cpp, Functions.h, SOCRAETES_emulator.ino]
2023-10-25 Remove access to LED_BUILTIN as it is used for SPI
2023-10-25 Remove access to LED_BUILTIN
