SepehrMosavat/SOCRAETES/(notices)

Notices in the files:
parts and their libraries:
IRF9530PBF: COPYRIGHT: Copyright (C) 2023 Ultra Librarian. All rights reserved.
